ellwoodthewood/BSidesSD/README.md

# BSidesSD

Copy contents of python folder to your badge (including lib folder) to program it. Badge will run code.py when it starts up.
