ellwoodthewood/BSidesSD/python_alt3/README.md

1. select a pattern file from this directory, and make a copy, renamed to `code.py`
2. remove at least one battery from the badge 
3. connect badge to computer using micro usb cable
4. badge should mount on desktop as a drive named `CIRCUITPY`
5. copy `code.py` file into `CIRCUITPY` drive
6. badge will immediately start running the new file
7. eject the drive before unplugging the drive

* download `mu-editor` for an environment-aware IDE: [https://codewith.mu/]
