ellwoodthewood/BSidesSD/bsidessd_rev2/bsidessd.kicad_pcb

## KiCad design bsidessd_rev2/bsidessd.kicad_pcb (2020-01-03)

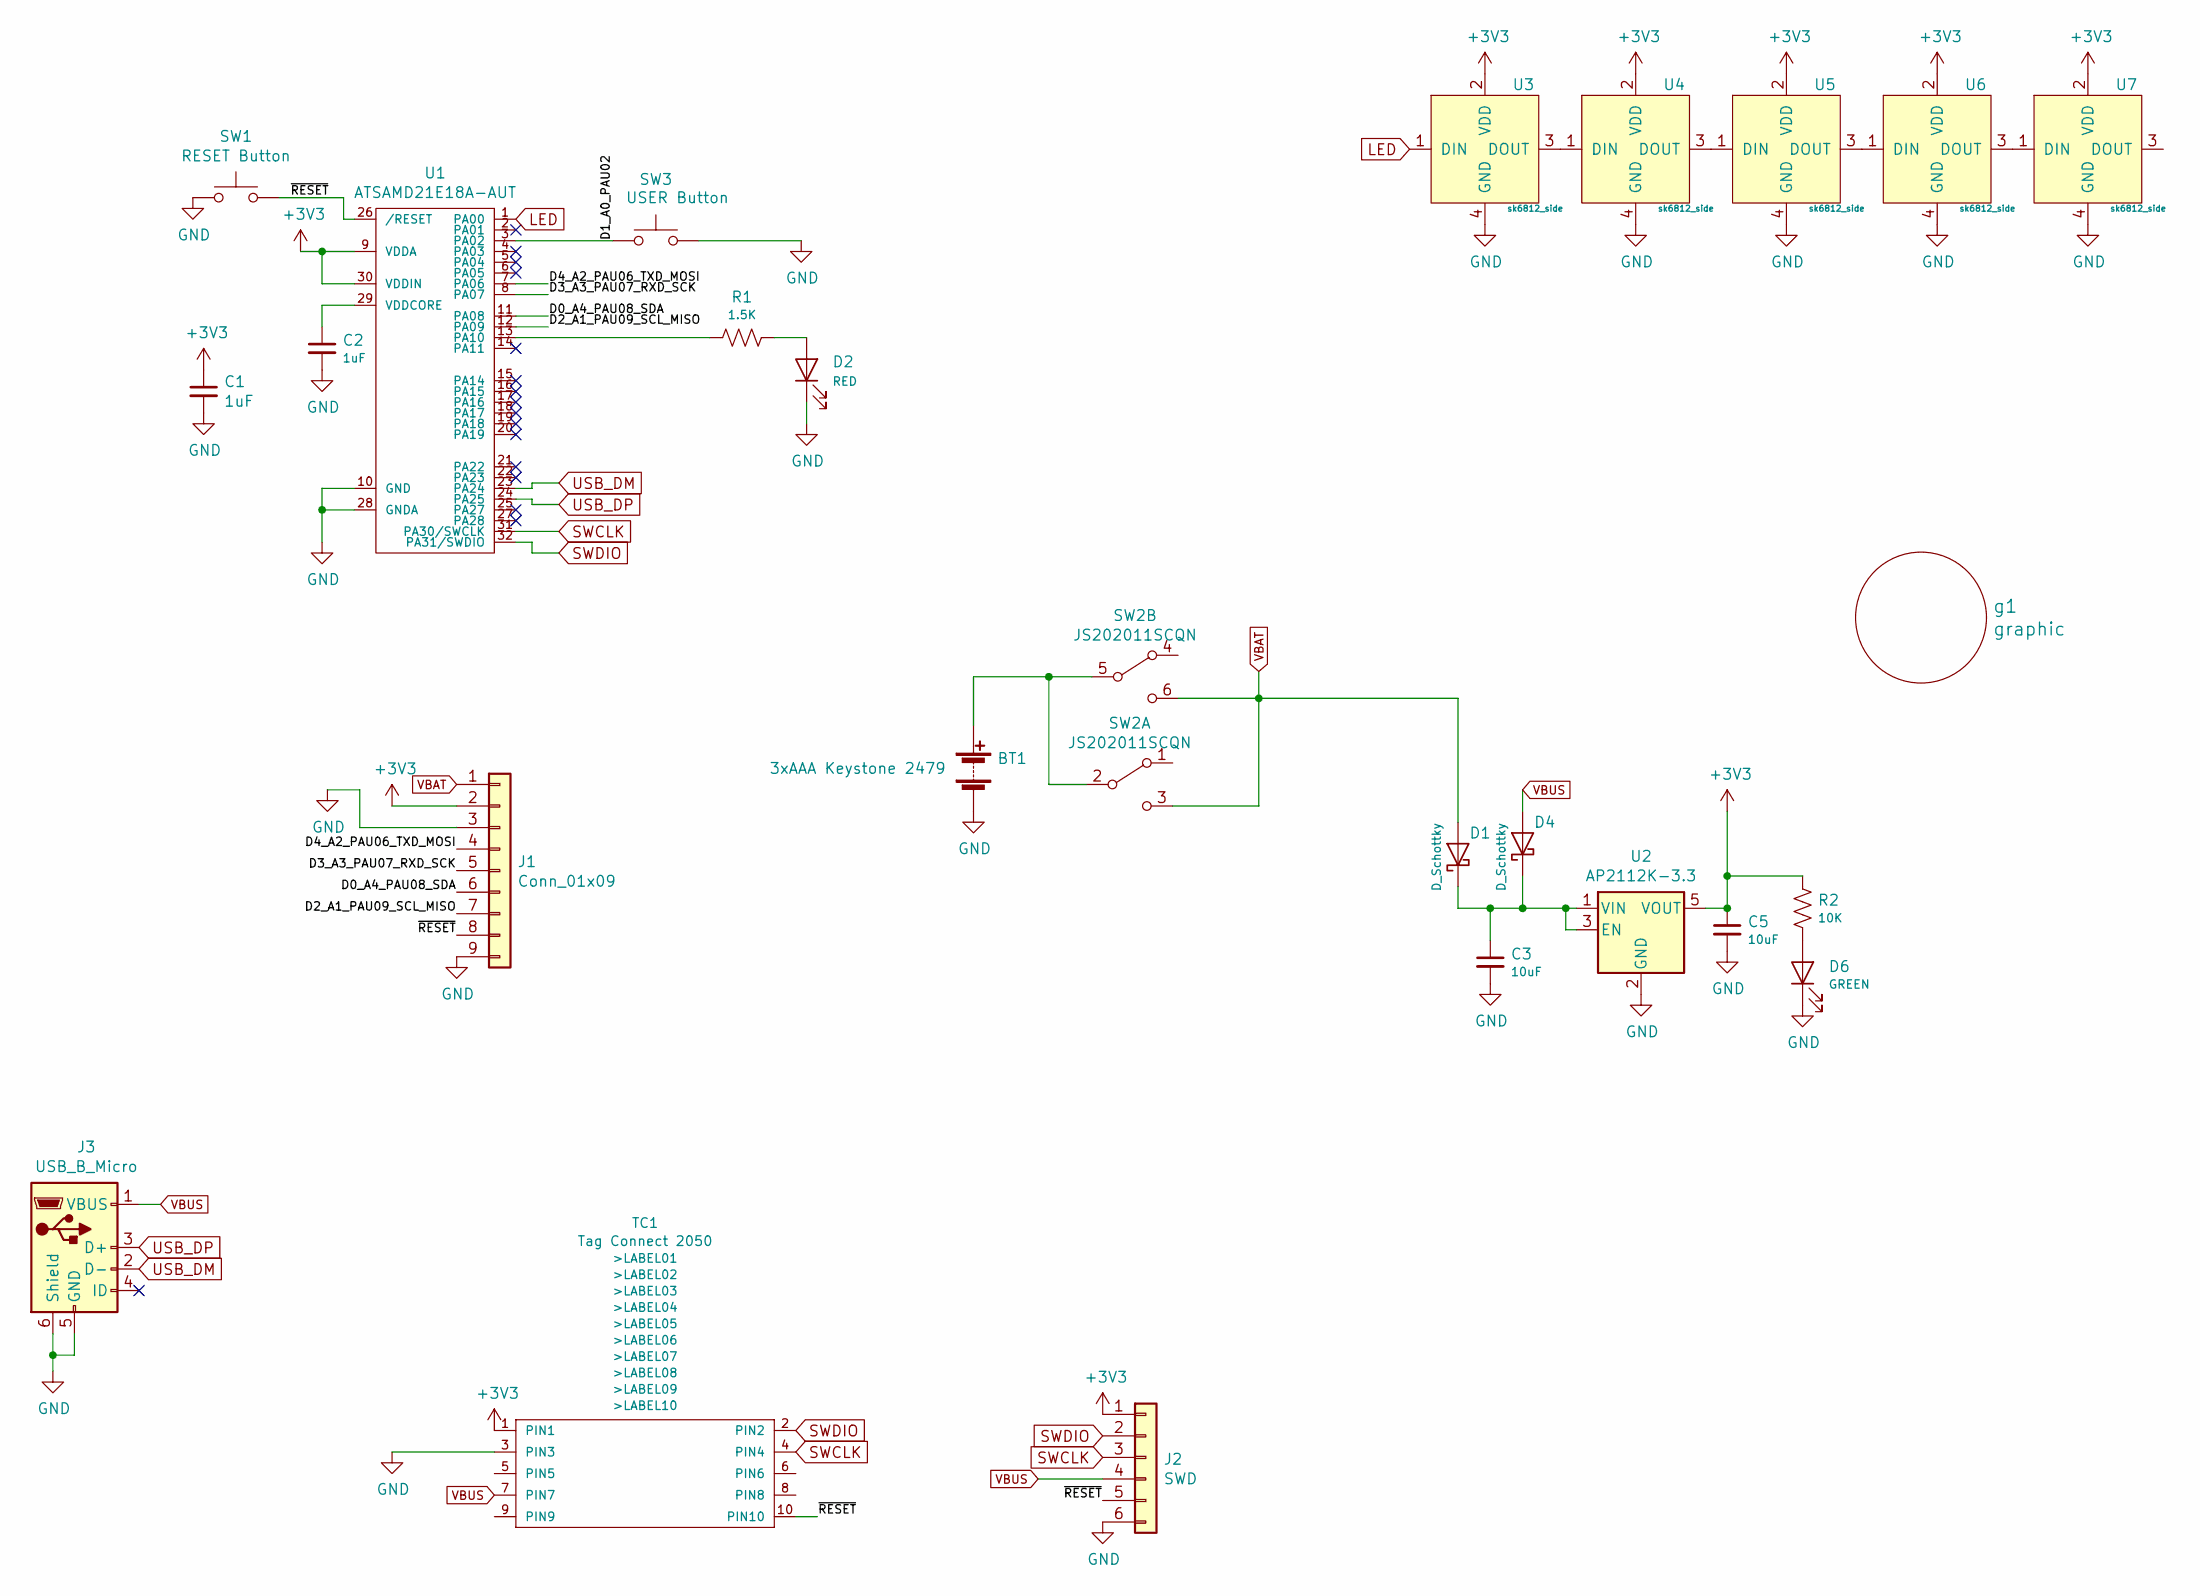
[picture p1: schematic bsidessd.sch, BSides SD 2020]

Parts:
BT1: 3xAAA Keystone 2479; BatteryHolder_Keystone_2479_3xAAA
C1, C2: 1uF; C_0805_2012Metric
C3, C5: 10uF; C_0805_2012Metric
D1, D4: D_Schottky; D_SOD-323
D2: RED; LED_0603_1608Metric
D6: GREEN; LED_0603_1608Metric
J1: Conn_01x09; PinHeader_1x09_P2.54mm_Vertical
J2: SWD; PinHeader_1x06_P2.54mm_Vertical
J3: USB_B_Micro; USB_Micro-B_Amphenol_10103594-0001LF_Horizontal
R1: 1.5K; R_0805_2012Metric
R2: 10K; R_0805_2012Metric
SW1: RESET Button; SW_SPST_PTS810
SW2: JS202011SCQN
SW3: USER Button; SW_SPST_PTS810
TC1: Tag Connect 2050; TC2050-IDC-FP-NoSilk
U1: ATSAMD21E18A-AUT; TQFP-32_7x7mm_P0.8mm
U2: AP2112K-3.3; SOT-23-5
U3, U4, U5, U6, U7: sk6812_side; LED_SK6812_SIDE
g1: graphic; bsidessd_rev2

Connections:
+3V3: C1.1, C5.1, J1.2, J2.1, R2.1, TC1.1 (PIN1), U1.9 (VDDA), U1.30 (VDDIN), U2.5 (VOUT), U3.2 (VDD), U4.2 (VDD), U5.2 (VDD), U6.2 (VDD), U7.2 (VDD)
/D0_A4_PAU08_SDA: J1.6, U1.11 (PA08)
/D1_A0_PAU02: SW3.1, U1.3 (PA02); also elsewhere on the board
/D2_A1_PAU09_SCL_MISO: J1.7, U1.12 (PA09)
/D3_A3_PAU07_RXD_SCK: J1.5, U1.8 (PA07)
/D4_A2_PAU06_TXD_MOSI: J1.4, U1.7 (PA06)
/~RESET: J1.8, J2.5, SW1.2, TC1.10 (PIN10), U1.26 (/RESET); also elsewhere on the board
GND: BT1.2 (-), C1.2, C2.2, C3.2, C5.2, D2.1 (K), D6.1 (K), J1.3, J1.9, J2.6, J3.5 (GND), J3.6 (Shield), SW1.1, SW3.2, TC1.3 (PIN3), U1.10 (GND), U1.28 (GNDA), U2.2 (GND), U3.4 (GND), U4.4 (GND), U5.4 (GND), U6.4 (GND), U7.4 (GND); also elsewhere on the board
LED: U1.1 (PA00), U3.1 (DIN)
unnamed: BT1.1 (+), SW2.2 (B), SW2.5 (B)
unnamed: C2.1, U1.29 (VDDCORE)
unnamed: C3.1, D1.1 (K), D4.1 (K), U2.1 (VIN), U2.3 (EN)
unnamed: D2.2 (A), R1.1
unnamed: D6.2 (A), R2.2
unnamed: R1.2, U1.13 (PA10)
unnamed: U3.3 (DOUT), U4.1 (DIN)
unnamed: U4.3 (DOUT), U5.1 (DIN)
unnamed: U5.3 (DOUT), U6.1 (DIN)
unnamed: U6.3 (DOUT), U7.1 (DIN)
SWCLK: J2.3, TC1.4 (PIN4), U1.31 (PA30/SWCLK)
SWDIO: J2.2, TC1.2 (PIN2), U1.32 (PA31/SWDIO)
USB_DM: J3.2 (D-), U1.23 (PA24)
USB_DP: J3.3 (D+), U1.24 (PA25)
VBAT: D1.2 (A), J1.1, SW2.3 (C), SW2.6 (C)
VBUS: D4.2 (A), J2.4, J3.1 (VBUS), TC1.7 (PIN7)

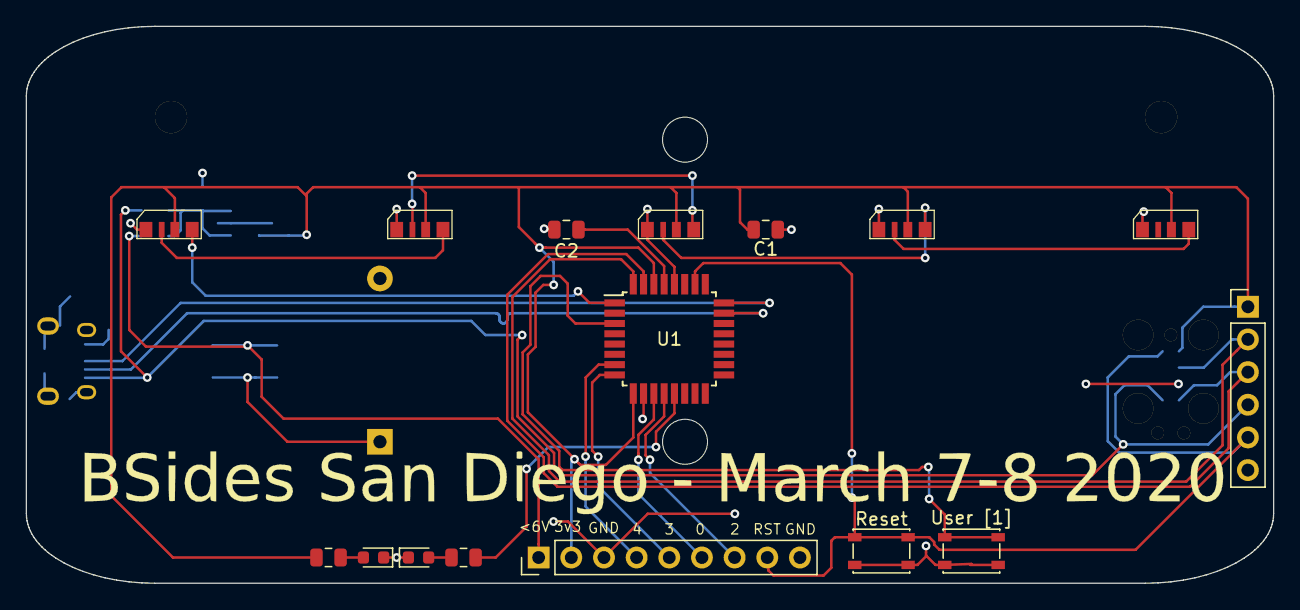
[picture p2: board bsidessd.kicad_pcb from above]

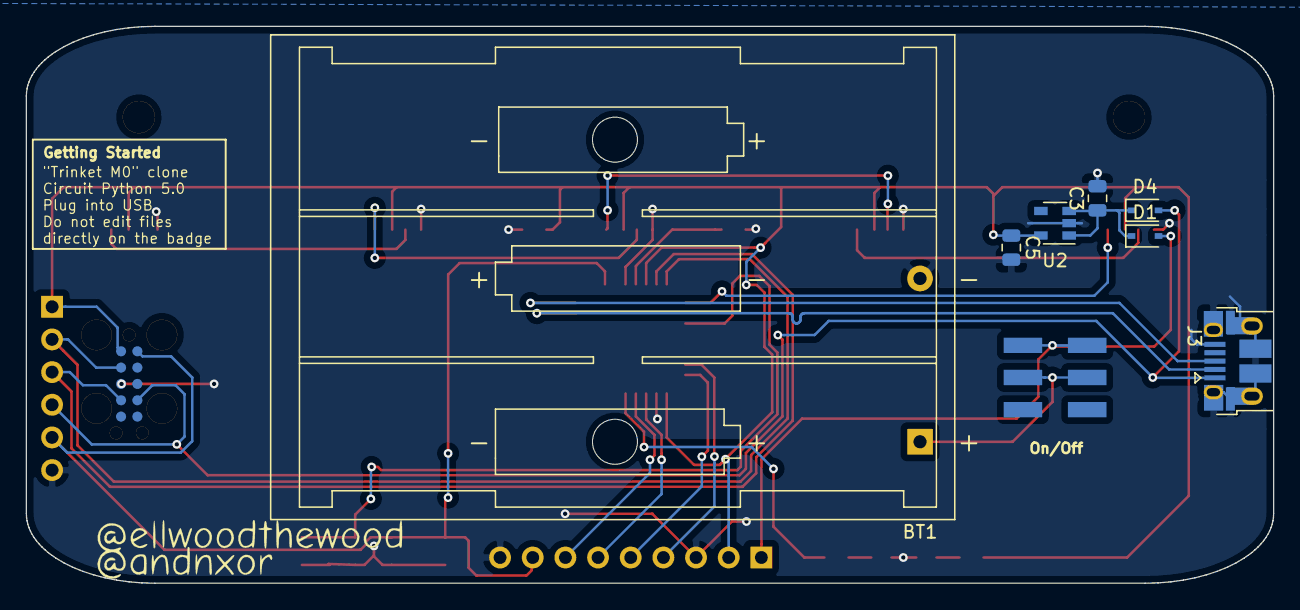
[picture p3: board bsidessd.kicad_pcb from below]

Board: 2 copper layers, 97.0 x 43.3 mm, 26 parts (9 on the bottom side), 25 nets.

Other parts of the board:
Reset: RESET Button; SW_SPST_PTS810
User [1]: USER Button; SW_SPST_PTS810

Their connections:
/D1_A0_PAU02: User [1].1; also elsewhere on the board
/~RESET: Reset.2; also elsewhere on the board
GND: Reset.1, User [1].2; also elsewhere on the board
