ellwoodthewood/BSidesSD/(threads)

Thread 5 (2019-12-31):

Remove diodes YOLO

ANDnXOR, 2019-12-31:

ANDnXOR, 2019-12-31:
Or just remove diode from battery double YOLO

ANDnXOR, 2020-01-02:
Design works fine with diodes. No need to YOLO.

Closed 2020-01-02.

Thread 11 (2020-01-01):

Reset button doesn't seem to work

ANDnXOR, 2020-01-01:

ANDnXOR, 2020-01-02:
Button was bad, likely due to cleaning.

Closed 2020-01-02.

Thread 17 (2020-01-11):

Remove reset and user buttons

ANDnXOR, 2020-01-11:

Closed 2020-01-12.

Thread 20 (2020-01-12):

LEDs need gamma correction

ANDnXOR, 2020-01-12:
https://learn.adafruit.com/fancyled-library-for-circuitpython/led-colors
