ellwoodthewood/BSidesSD/python_alt3/hbad.py

from flask import Flask
from flask_bcrypt import Bcrypt
from flask_sqlalchemy import SQLAlchemy
import logging
import os
import argparse

parser = argparse.ArgumentParser()
parser.add_argument("-gk", "--googlekey", dest="googlekey", type=str, default='',
                    help="Google API Key")
parser.add_argument("-ik", "--ipstackkey", dest="ipstackkey", type=str, default='',
                    help="IPStack API Key")

opts = parser.parse_args()

basedir = os.path.abspath(os.path.dirname(__file__))

# configuration
SQLALCHEMY_DATABASE_URI = 'sqlite:///' + os.path.join(basedir, 'data.db')
DEBUG = True
SECRET_KEY = 'development key'
SQLALCHEMY_TRACK_MODIFICATIONS = False
GOOGLE_API_KEY = opts.googlekey   # Provide your google api key via command-line argument
IPSTACK_API_KEY = opts.ipstackkey

app = Flask(__name__)
app.config.from_object(__name__)
bcrypt = Bcrypt(app)
db = SQLAlchemy(app)
# Logger cannot be imported until the db is initialized
from honeybadger.utils import Logger
logger = Logger()

if __name__ != '__main__':
    gunicorn_logger = logging.getLogger('gunicorn.error')
    # only use handler if gunicorn detected, otherwise default
    if gunicorn_logger.handlers:
        app.logger.handlers = gunicorn_logger.handlers
        app.logger.setLevel(gunicorn_logger.level)

from honeybadger import models
from honeybadger import views

def initdb(username, password):
    db.create_all()
    import binascii
    u = models.User(email=username, password_hash=bcrypt.generate_password_hash(binascii.hexlify(password.encode())), role=0, status=1)
    db.session.add(u)
    db.session.commit()
    print('Database initialized.')
    # remove below for production
    t = models.Target(name='demo', guid='aedc4c63-8d13-4a22-81c5-d52d32293867')
    db.session.add(t)
    db.session.commit()
    b = models.Beacon(target_guid='aedc4c63-8d13-4a22-81c5-d52d32293867', agent='HTML', ip='1.2.3.4', port='80', useragent='Mac OS X', comment='this is a comment.', lat='38.2531419', lng='-85.7564855', acc='5')
    db.session.add(b)
    db.session.commit()
    b = models.Beacon(target_guid='aedc4c63-8d13-4a22-81c5-d52d32293867', agent='HTML', ip='5.6.7.8', port='80', useragent='Mac OS X', comment='this is a comment.', lat='34.855117', lng='-82.114192', acc='1')
    db.session.add(b)
    db.session.commit()

def dropdb():
    db.drop_all()
    print('Database dropped.')
