ellwoodthewood/BSidesSD/(commit log)

2019-11-26 update 1
    [bsidessd.kicad_pcb, bsidessd.sch]
2019-11-26 Initial design started
    [bsidessd.sch]
2019-11-27 Updated samples
2019-11-28 Update to pcb and acrylic
    [bsidessd-B.Cu.gbr, bsidessd-B.Mask.gbr, bsidessd-B.SilkS.gbr, bsidessd-Edge.Cuts.gbr, bsidessd-F.Cu.gbr, bsidessd-F.Mask.gbr, bsidessd-F.SilkS.gbr, bsidessd.drl]
2020-01-01 Logging build of first prototype.
2020-01-01 Initial Circuit Python working.
2020-01-02 Starting rev2. Schematic is done. Need a new PCB.
    [bsidessd-B.Cu.gbr, bsidessd-B.Mask.gbr, bsidessd-B.SilkS.gbr, bsidessd-Edge.Cuts.gbr, bsidessd-F.Cu.gbr, bsidessd-F.Mask.gbr, bsidessd-F.SilkS.gbr, bsidessd.drl]
2020-01-03 Passes DRC :) Need a sanity check before ordering.
    [bsidessd.kicad_pcb, bsidessd.sch]
2020-01-03 Cleaned up traces and silk. Ordered rev2 boards.
    [bsidessd-B.Cu.gbr, bsidessd-B.Mask.gbr, bsidessd-B.SilkS.gbr, bsidessd-B_Cu.gbl, bsidessd-B_Mask.gbs, bsidessd-B_SilkS.gbo, bsidessd-Edge.Cuts.gbr, bsidessd-Edge_Cuts.gm1]
